RishWijewardhena/Hena-Jet/machanical part/camera bracket/v-slot-aluminium-extrusion-bar-20mm-x-20mm-1.snapshot.15/Dimensions - Cross Section.PNG

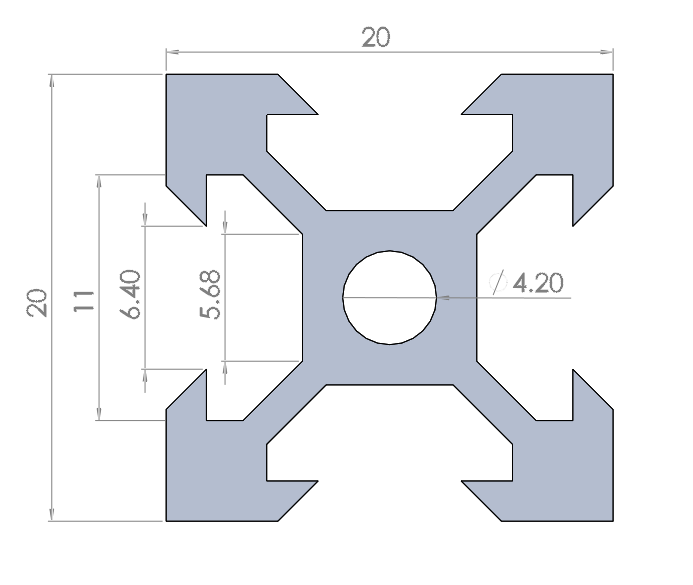
machanical part/camera bracket/v-slot-aluminium-extrusion-bar-20mm-x-20mm-1.snapshot.15/Dimensions - Cross Section.PNG
