RishWijewardhena/Hena-Jet/machanical part/camera bracket/Assembly 1.stl

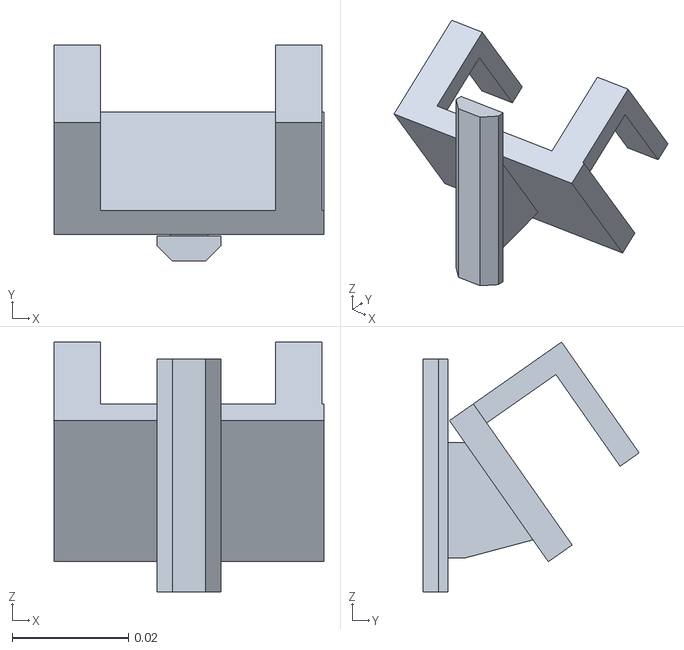
[picture p25: CAD file, 2026-07-02]
machanical part/camera bracket/Assembly 1.stl
0.0464 x 0.0371 x 0.0429
