RishWijewardhena/Hena-Jet/machanical part/camera bracket/flat camera bracket.step

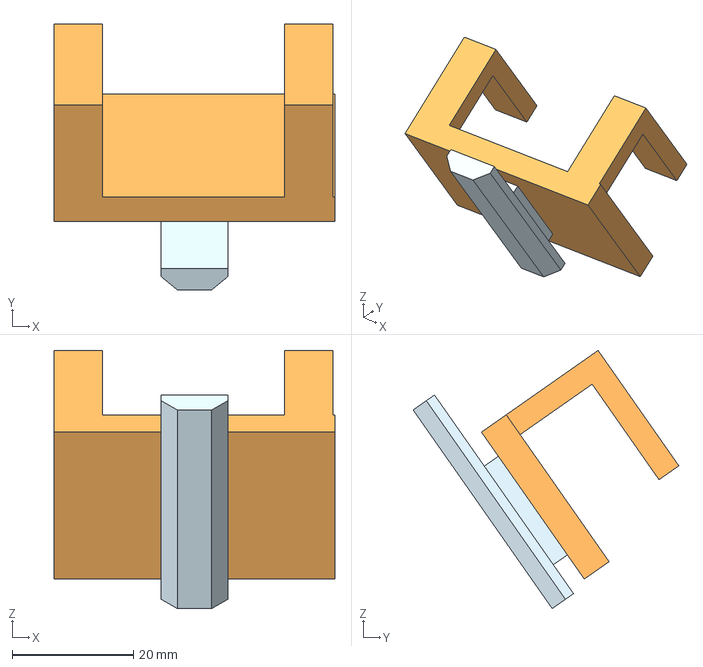
[picture p26: CAD file, 2026-07-16]
machanical part/camera bracket/flat camera bracket.step
46.4 x 43.8 x 42.6 mm
