RishWijewardhena/Hena-Jet/machanical part/camera bracket/v-slot-aluminium-extrusion-bar-20mm-x-20mm-1.snapshot.15/model (V-Slot 20x20mm).SLDPRT

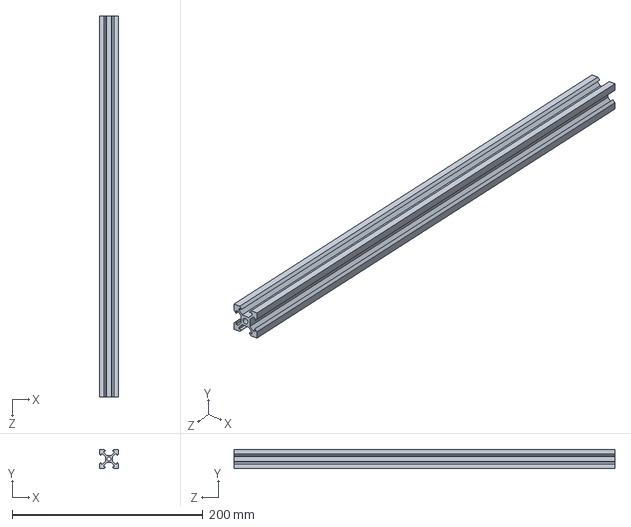
[picture p27: CAD file, 2026-07-02]
machanical part/camera bracket/v-slot-aluminium-extrusion-bar-20mm-x-20mm-1.snapshot.15/model (V-Slot 20x20mm).SLDPRT
20.0 x 20.0 x 400.0 mm
