RishWijewardhena/Hena-Jet/machanical part/camera bracket/camera_mount.step

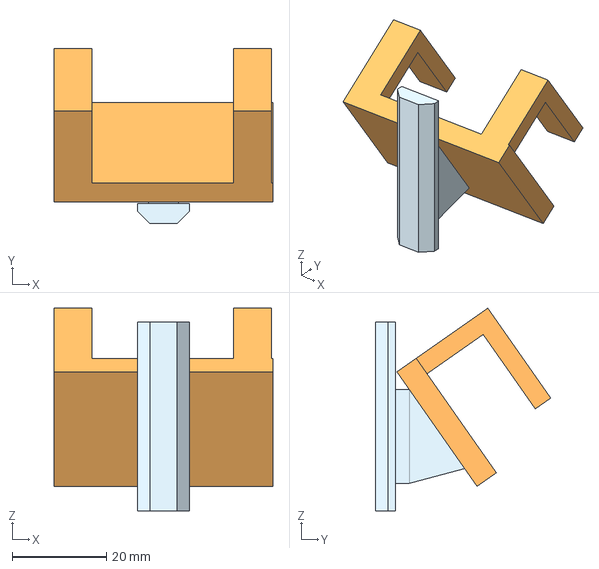
[picture p28: CAD file, 2026-07-02]
machanical part/camera bracket/camera_mount.step
46.4 x 37.1 x 42.9 mm
