RishWijewardhena/Hena-Jet/(list of files, cad)

Other CAD files:
machanical part/camera bracket/flat camera bracket.stl
