RishWijewardhena/Hena-Jet/scripts/sync_workflow/main_scan.py

#!/usr/bin/env python3
"""Main orchestrator for 360-degree motor-controlled scanning.

Captures aligned RGB-D frames at each motor angle, saves per-angle PLY files,
and optionally invokes reconstruct_pipeline.py for Open3D/Trimesh-based
registration and merging.
"""

import argparse
import json
import logging
import subprocess
import sys
import time

import numpy as np
from pathlib import Path

from motor_controller import MotorController
from camera_controller import CameraController
from pointcloud_export import backproject_to_points
from orbit_geometry import select_orbit_geometry, load_orbit_geometry, validate_camera_frame

logging.basicConfig(level=logging.INFO, format="%(asctime)s [%(levelname)s] %(message)s")
logger = logging.getLogger(__name__)


def parse_args(argv=None):
    parser = argparse.ArgumentParser(description="360 Motor-Controlled Scanner")
    parser.add_argument("--port", type=str, default="/dev/ttyACM0", help="Motor controller serial port")
    parser.add_argument("--baud", type=int, default=250000, help="Baud rate")
    parser.add_argument("--step-deg", type=float, default=10.0, help="Degrees to step per capture")
    parser.add_argument("--disparity", type=str, default="128", choices=["128", "256"], help="Disparity search range")
    parser.add_argument("--width", type=int, default=1280, help="Camera width resolution")
    parser.add_argument("--height", type=int, default=800, help="Camera height resolution")
    parser.add_argument("--fps", type=int, default=30, help="Camera framerate")
    parser.add_argument("--radius-m", type=float, default=None,
                        help="Radius from camera optical center to orbit center in metres "
                             "(defaults to the measured calibration radius)")
    parser.add_argument(
        "--x-positions-mm",
        type=float,
        nargs="+",
        default=[150.0],
        help="Absolute X stations to scan in millimetres (default: 150)",
    )
    parser.add_argument("--orbit-geometry", type=Path, default=None,
                        help="Measured calibration JSON (default: repository outputs/test_radius_x100/radius_calibration.json)")
    parser.add_argument("--orbit-axis", type=float, nargs=3, default=[1.0, 0.0, 0.0],
                        help="Legacy axis option; measured calibration supplies the reconstruction axis")
    parser.add_argument("--registration-mode", choices=("motor", "guarded-icp"),
                        default="guarded-icp",
                        help="Reconstruction pose source (default: guarded-icp). "
                             "Guarded ICP records per-edge fitness, residual and "
                             "loop closure, which motor mode does not produce at "
                             "all, and falls back to the motor prior whenever a "
                             "correction fails its guards. Pass motor to skip ICP")
    parser.add_argument(
        "--exclude-high-drift-frames",
        action="store_true",
        help=(
            "When auto-reconstructing with guarded ICP, omit sequential frames "
            "whose ICP correction exceeds the pose guards"
        ),
    )
    parser.add_argument("--frames-per-angle", type=int, default=6,
                        help="Fresh RGB-D frames to median-combine at each angle")
    parser.add_argument("--min-valid-samples", type=int, default=3,
                        help="Valid temporal samples a pixel needs to survive fusion")
    parser.add_argument("--depth-min-m", type=float, default=0.02,
                        help="Discard depth closer than this distance")
    parser.add_argument("--depth-max-m", type=float, default=0.25,
                        help="Discard depth farther than this distance")
    parser.add_argument("--crop-radius-m", type=float, default=0.085,
                        help="Final reconstruction crop limit around the orbit center")
    parser.add_argument(
        "--registration-crop-radius-m",
        type=float,
        default=None,
        help=(
            "Tighter crop-cube half-extent used only by guarded ICP "
            "(default: min(final crop, 0.10 m))"
        ),
    )
    parser.add_argument(
        "--crop-shape",
        choices=("cube", "cylinder"),
        default="cylinder",
        help=(
            "Reconstruction crop geometry: 'cylinder' reads the crop radii as "
            "radial limits around the orbit axis, which drops the enclosure "
            "ring without clipping the object along the axis (default: cube)"
        ),
    )
    parser.add_argument(
        "--crop-axial-half-length-m",
        type=float,
        default=0.30,
        help="Half-length along the orbit axis for --crop-shape cylinder",
    )
    parser.add_argument("--output-dir", type=Path, default=Path("outputs/scan"), help="Output directory for PLY files")
    parser.add_argument("--dry-run", action="store_true", help="Print sequence without moving or capturing")
    parser.add_argument("--no-home", action="store_true", help="Skip the homing sequence (use only if already homed)")
    parser.add_argument("--reconstruct", action="store_true", help="Auto-run reconstruct_pipeline.py after capture")

    args = parser.parse_args(argv)
    if args.registration_crop_radius_m is None:
        args.registration_crop_radius_m = 0.10
        if args.crop_radius_m > 0.0:
            args.registration_crop_radius_m = min(
                args.registration_crop_radius_m,
                args.crop_radius_m,
            )
    args.orbit_geometry = select_orbit_geometry(args.orbit_geometry)
    return args


def generate_angle_sequence(step_deg):
    """Generates the scan sequence: 0 to 180, then back to 0, then to -180."""
    sequence = []

    # 0 to 180
    pos_angles = np.arange(0.0, 180.0 + step_deg, step_deg)
    for ang in pos_angles:
        sequence.append({"angle": ang, "capture": True})

    # Return to 0 without capturing
    sequence.append({"angle": 0.0, "capture": False})

    # -step to -180
    neg_angles = np.arange(-step_deg, -180.0 - step_deg, -step_deg)
    for ang in neg_angles:
        sequence.append({"angle": ang, "capture": True})

    return sequence


def generate_scan_sequence(step_deg, x_positions_mm):
    """Build safe absolute-X moves and one complete orbit per X station."""
    sequence = []
    for station_index, x_position_mm in enumerate(x_positions_mm):
        sequence.append({
            "kind": "move_x",
            "capture": False,
            "station_index": station_index,
            "x_position_mm": float(x_position_mm),
        })
        for angle_step in generate_angle_sequence(step_deg):
            sequence.append({
                "kind": "move_y",
                "capture": angle_step["capture"],
                "station_index": station_index,
                "x_position_mm": float(x_position_mm),
                "angle_deg": float(angle_step["angle"]),
            })
        # Always put Y at zero before the next absolute X move.
        sequence.append({
            "kind": "move_y",
            "capture": False,
            "station_index": station_index,
            "x_position_mm": float(x_position_mm),
            "angle_deg": 0.0,
        })
    return sequence


def capture_filename(station_index, x_position_mm, angle_deg):
    """Return a unique, sortable filename for one station/angle capture."""
    return (
        f"frame_s{station_index:02d}_x{x_position_mm:.1f}_"
        f"y{angle_deg:+06.1f}.ply"
    )


def color_frame_to_rgb(color_frame):
    """Convert Orbbec color frame to numpy RGB array."""
    width = color_frame.get_width()
    height = color_frame.get_height()
    data = np.frombuffer(color_frame.get_data(), dtype=np.uint8).reshape((height, width, 3))
    return data


def depth_frame_to_meters(depth_frame):
    """Convert Orbbec depth frame to meters as float32."""
    width = depth_frame.get_width()
    height = depth_frame.get_height()
    depth_scale_mm = float(depth_frame.get_depth_scale())
    depth_raw = np.frombuffer(depth_frame.get_data(), dtype=np.uint16).reshape((height, width))
    depth_m = depth_raw.astype(np.float32) * (depth_scale_mm / 1000.0)
    return depth_m


def fuse_depth_frames(depth_frames, *, min_depth_m, max_depth_m, min_valid_samples=1):
    """Median-combine valid depth samples and mask points outside the work area."""
    if not depth_frames:
        raise ValueError("At least one depth frame is required.")
    if min_depth_m < 0.0 or max_depth_m <= min_depth_m:
        raise ValueError("Depth range must satisfy 0 <= min_depth_m < max_depth_m.")

    shapes = {np.asarray(frame).shape for frame in depth_frames}
    if len(shapes) != 1:
        raise ValueError("All depth frames must have the same shape.")

    stack = np.stack(depth_frames).astype(np.float32, copy=False)
    valid = (
        np.isfinite(stack)
        & (stack >= min_depth_m)
        & (stack <= max_depth_m)
    )
    masked = np.ma.array(stack, mask=~valid)
    fused = np.ma.median(masked, axis=0).filled(0.0).astype(np.float32)
    if min_valid_samples > 1:
        fused[valid.sum(axis=0) < min_valid_samples] = 0.0
    return fused


def capture_fused_rgbd(
    camera,
    *,
    frames_per_angle,
    timeout_ms,
    min_depth_m,
    max_depth_m,
    min_valid_samples=1,
):
    """Capture a fresh burst and return the latest color plus median depth."""
    if frames_per_angle < 1:
        raise ValueError("frames_per_angle must be at least 1.")

    depth_frames = []
    latest_color = None
    for _ in range(frames_per_angle):
        color_frame, depth_frame = camera.capture_aligned_rgbd(timeout_ms=timeout_ms)
        if color_frame is None or depth_frame is None:
            continue
        latest_color = color_frame_to_rgb(color_frame).copy()
        depth_frames.append(depth_frame_to_meters(depth_frame))

    if latest_color is None or not depth_frames:
        return None, None, 0

    fused_depth = fuse_depth_frames(
        depth_frames,
        min_depth_m=min_depth_m,
        max_depth_m=max_depth_m,
        min_valid_samples=min_valid_samples,
    )
    return latest_color, fused_depth, len(depth_frames)


def build_scan_metadata(args, *, active_disparity, captured_angles, captures=None):
    """Create the portable capture contract consumed by reconstruction."""
    return {
        "schema_version": 2,
        "orbit_radius_m": args.radius_m,
        "orbit_geometry_source": str(args.orbit_geometry),
        "orbit_axis": [float(value) for value in args.orbit_axis],
        "step_deg": float(args.step_deg),
        "registration_mode": args.registration_mode,
        "exclude_high_drift_frames": bool(args.exclude_high_drift_frames),
        "capture": {
            "width": int(args.width),
            "height": int(args.height),
            "fps": int(args.fps),
            "disparity": int(active_disparity),
            "frames_per_angle": int(args.frames_per_angle),
            "min_valid_samples": int(args.min_valid_samples),
            "depth_range_m": [float(args.depth_min_m), float(args.depth_max_m)],
        },
        "reconstruction": {
            "crop_radius_m": float(args.crop_radius_m),
            "registration_crop_radius_m": float(args.registration_crop_radius_m),
            "crop_shape": args.crop_shape,
            "crop_axial_half_length_m": float(args.crop_axial_half_length_m),
        },
        "x_stage": {
            "positions_mm": [float(value) for value in args.x_positions_mm],
            "reference_position_mm": float(args.x_positions_mm[0]),
            "positive_direction": "+orbit_axis",
        },
        "captured_angles_deg": [float(value) for value in captured_angles],
        "captures": list(captures or []),
    }


def save_frame_as_ply(
    color_rgb,
    depth_m,
    intrinsics,
    angle_deg,
    output_dir,
    *,
    depth_trunc_m=3.0,
    filename=None,
):
    """Create a colored point cloud from RGBD and save as PLY."""
    import open3d as o3d

    points, colors = backproject_to_points(
        depth_m, color_rgb, intrinsics, depth_trunc_m=depth_trunc_m
    )
    pcd = o3d.geometry.PointCloud()
    pcd.points = o3d.utility.Vector3dVector(points)
    pcd.colors = o3d.utility.Vector3dVector(colors)

    out_path = output_dir / (filename or f"frame_{angle_deg:.1f}.ply")
    o3d.io.write_point_cloud(str(out_path), pcd)
    logger.info("Saved %d points -> %s", len(pcd.points), out_path.name)
    return out_path


def prepare_scan_geometry(args):
    """Validate the rig calibration before hardware access and resolve metadata."""
    calibration = load_orbit_geometry(args.orbit_geometry)
    if args.radius_m is None:
        args.radius_m = float(calibration["recommended_radius_m"])
    if not np.isfinite(args.radius_m) or args.radius_m <= 0:
        raise ValueError("--radius-m must be finite and positive")
    args.orbit_axis = calibration["orbit_geometry"]["axis"]
    return calibration


def build_reconstruction_command(args):
    """Forward the same measured geometry used to describe the scan."""
    cmd = [
        sys.executable,
        str(Path(__file__).parent / "reconstruct_pipeline.py"),
        "--input-dir", str(args.output_dir),
        "--orbit-radius-m", str(args.radius_m),
        "--registration-mode", args.registration_mode,
        "--orbit-geometry", str(args.orbit_geometry),
        "--crop-radius-m", str(args.crop_radius_m),
        "--registration-crop-radius-m", str(args.registration_crop_radius_m),
        "--crop-shape", args.crop_shape,
        "--crop-axial-half-length-m", str(args.crop_axial_half_length_m),
    ]
    if args.exclude_high_drift_frames:
        cmd.append("--exclude-high-drift-frames")

    return cmd


def main():
    args = parse_args()

    if args.frames_per_angle < 1:
        raise ValueError("--frames-per-angle must be at least 1.")
    if args.min_valid_samples < 1 or args.min_valid_samples > args.frames_per_angle:
        raise ValueError("--min-valid-samples must be within [1, --frames-per-angle].")
    if args.depth_min_m < 0.0 or args.depth_max_m <= args.depth_min_m:
        raise ValueError("Depth range must satisfy 0 <= min < max.")
    if args.radius_m is not None and args.radius_m <= 0.0:
        raise ValueError("--radius-m must be positive.")
    if not np.isfinite(args.crop_radius_m) or args.crop_radius_m <= 0.0:
        raise ValueError("--crop-radius-m must be finite and positive.")
    if (
        not np.isfinite(args.registration_crop_radius_m)
        or args.registration_crop_radius_m <= 0.0
    ):
        raise ValueError("--registration-crop-radius-m must be finite and positive.")
    if (
        not np.isfinite(args.crop_axial_half_length_m)
        or args.crop_axial_half_length_m <= 0.0
    ):
        raise ValueError("--crop-axial-half-length-m must be finite and positive.")
    if not args.x_positions_mm or not all(np.isfinite(args.x_positions_mm)):
        raise ValueError("--x-positions-mm must contain finite positions.")
    if len(set(args.x_positions_mm)) != len(args.x_positions_mm):
        raise ValueError("--x-positions-mm must not contain duplicates.")
    if len({f"{value:.1f}" for value in args.x_positions_mm}) != len(args.x_positions_mm):
        raise ValueError("--x-positions-mm must be unique at 0.1 mm precision.")
    calibration = prepare_scan_geometry(args)
    if args.exclude_high_drift_frames and args.registration_mode != "guarded-icp":
        raise ValueError("--exclude-high-drift-frames requires guarded-icp")

    # Ensure output dir exists
    args.output_dir.mkdir(parents=True, exist_ok=True)

    scan_sequence = generate_scan_sequence(args.step_deg, args.x_positions_mm)

    if args.dry_run:
        logger.info("[DRY RUN] Would home motors here.")
        logger.info("[DRY RUN] Would select absolute positioning with G90.")
        for step in scan_sequence:
            if step["kind"] == "move_x":
                logger.info(
                    "[DRY RUN] Would move X to %.1f mm at Y=0.",
                    step["x_position_mm"],
                )
                continue
            angle = step["angle_deg"]
            logger.info("[DRY RUN] Would move Y to %.1f degrees.", angle)
            if step["capture"]:
                logger.info(
                    "[DRY RUN] Would capture station %d at X=%.1f, Y=%.1f.",
                    step["station_index"], step["x_position_mm"], angle,
                )
        logger.info("[DRY RUN] Sequence complete.")
        return

    logger.info("Initializing hardware...")

    saved_files = []
    captured_angles = []
    capture_manifest = []
    metadata_path = args.output_dir / "scan_metadata.json"

    with MotorController(port=args.port, baud=args.baud) as motor, \
         CameraController(width=args.width, height=args.height, fps=args.fps, disparity=args.disparity) as camera:

        validate_camera_frame(calibration, camera.intrinsics)

        if not args.no_home:
            motor.home_all()
        if not motor.send_command("G90"):
            raise RuntimeError("Failed to select absolute motor positioning.")

        # Save intrinsics once
        if camera.intrinsics:
            intrinsics_path = args.output_dir / "intrinsics.json"
            intrinsics_path.write_text(
                json.dumps(camera.intrinsics, indent=2), encoding="utf-8",
            )
            logger.info("Saved intrinsics to %s", intrinsics_path)

        metadata_path.write_text(
            json.dumps(
                build_scan_metadata(
                    args,
                    active_disparity=camera.active_disparity,
                    captured_angles=captured_angles,
                    captures=capture_manifest,
                ),
                indent=2,
            ) + "\n",
            encoding="utf-8",
        )
        logger.info("Saved scan settings to %s", metadata_path)

        logger.info("Starting scan with %d motion steps.", len(scan_sequence))

        for step in scan_sequence:
            if step["kind"] == "move_x":
                logger.info(
                    "Moving to station %d at X=%.1f mm...",
                    step["station_index"], step["x_position_mm"],
                )
                motor.move_x(step["x_position_mm"], feedrate=500)
                time.sleep(0.5)
                continue

            angle = step["angle_deg"]
            should_capture = step["capture"]

            logger.info("Moving Y to %.1f degrees...", angle)
            motor.move_y(angle, feedrate=800)

            # Brief pause to let camera settle after movement
            time.sleep(0.1)

            if should_capture:
                logger.info("Capturing frame at %.1f degrees...", angle)
                color_rgb, depth_m, captured_count = capture_fused_rgbd(
                    camera,
                    frames_per_angle=args.frames_per_angle,
                    timeout_ms=2000,
                    min_depth_m=args.depth_min_m,
                    max_depth_m=args.depth_max_m,
                    min_valid_samples=args.min_valid_samples,
                )

                if color_rgb is not None and depth_m is not None:
                    valid_percent = 100.0 * np.count_nonzero(depth_m) / depth_m.size
                    logger.info(
                        "Combined %d/%d frames; %.1f%% valid depth in %.3f-%.3f m",
                        captured_count,
                        args.frames_per_angle,
                        valid_percent,
                        args.depth_min_m,
                        args.depth_max_m,
                    )
                    ply_path = save_frame_as_ply(
                        color_rgb,
                        depth_m,
                        camera.intrinsics,
                        angle,
                        args.output_dir,
                        depth_trunc_m=args.depth_max_m,
                        filename=capture_filename(
                            step["station_index"],
                            step["x_position_mm"],
                            angle,
                        ),
                    )
                    saved_files.append(ply_path)
                    captured_angles.append(float(angle))
                    capture_manifest.append({
                        "filename": ply_path.name,
                        "station_index": int(step["station_index"]),
                        "x_position_mm": float(step["x_position_mm"]),
                        "x_offset_m": float(
                            (step["x_position_mm"] - args.x_positions_mm[0]) / 1000.0
                        ),
                        "angle_deg": float(angle),
                    })
                    metadata_path.write_text(
                        json.dumps(
                            build_scan_metadata(
                                args,
                                active_disparity=camera.active_disparity,
                                captured_angles=captured_angles,
                                captures=capture_manifest,
                            ),
                            indent=2,
                        ) + "\n",
                        encoding="utf-8",
                    )
                else:
                    logger.error(
                        "Failed to capture any complete frame at %.1f degrees. Skipping.",
                        angle,
                    )
            else:
                logger.info("Returning to %.1f degrees (no capture).", angle)

    logger.info("Capture complete. Saved %d point clouds to %s", len(saved_files), args.output_dir)

    # Optionally invoke reconstruction
    if args.reconstruct and len(saved_files) > 0:
        logger.info("Launching reconstruction pipeline...")
        cmd = build_reconstruction_command(args)

        logger.info("$ %s", " ".join(cmd))
        subprocess.run(cmd, check=True)
    elif len(saved_files) > 0:
        logger.info(
            "To reconstruct, run:\n"
            "  python %s/reconstruct_pipeline.py --input-dir %s",
            Path(__file__).parent,
            args.output_dir,
        )
    else:
        logger.warning("No frames were captured.")


if __name__ == "__main__":
    main()
