RishWijewardhena/Hena-Jet/(commit log)

2026-06-22 chore: initialize scanner project workspace
    - Add the project README and initial scanner feasibility notes for the ZED-M workflow.
    - Add baseline ZED angle capture, circular point-cloud merge, and TSDF fusion scripts.
    - Add calibration sweep helpers and ignore rules for generated scanner outputs.
2026-06-23 feat: add camera capture and KISS-ICP mapping tools
    - Add interactive OAK-D RGB-D capture and point-cloud export for manual scanner angles.
    - Add interactive ZED RGB-D capture with IMAGE coordinate support and point-cloud export.
    - Add realtime ZED KISS-ICP mapping with live Open3D visualization and trajectory export.
    - Update circular point-cloud merging for IMAGE captures, rig pivot correction, and optional ICP refinement.
    - Add offline KISS-ICP local-map export from captured point-cloud datasets.
2026-06-24 feat: add live ZED TSDF posegraph mapper
    - Capture ZED left RGB-D frames for Open3D odometry without relying on IMU or KISS-ICP.
    - Build live TSDF previews for single-circle and guided scanning modes.
    - Optimize the pose graph after capture and rebuild final mesh, cloud, pose, and scan metadata outputs.
2026-07-02 feat: add multi-camera reconstruction workflows
    - Add ZED Mini capture, Open3D dataset export, offline reconstruction, and TSDF rebuild scripts.
    - Add ZED-M ArUco table-board alignment tools for printable marker generation, pose debugging, and marker-based TSDF fusion.
    - Add OAK-D live and offline circular TSDF fusion scripts for manual-angle RGB-D scanning.
    - Update the live ZED posegraph mapper and local ignore rules for scanner runtime artifacts.
2026-07-02 docs: add scanner reference notes
    - Add the Johnson and Lorenzo report notes used to reason about fixed-object, moving-camera scanning.
    - Add the original Johnson and Lorenzo report PDF for future reference.
    - Add Open3D reconstruction notes explaining the RGB-D, posegraph, and TSDF concepts used by the scanner scripts.
2026-07-02 chore: keep ZED-M branch focused
    - Remove OAK-D capture and TSDF fusion scripts from the ZED-M branch.
    - Keep ZED, ZED-M, ArUco alignment, reconstruction utilities, and shared scanner docs on this branch.
    - Preserve OAK-D work in its own camera-specific branch for future development.
2026-07-02 chore: add ZED-M camera bracket design
    - Add the ZED-M camera mount STEP and assembled STL design files.
    - Add the 20x20 V-slot extrusion reference model, previews, and snapshot archive used by the bracket design.
    - Keep the mechanical bracket assets with the ZED-M branch because the design is camera-specific.
    [Assembly 1.stl, camera_mount.step, model (V-Slot 20x20mm).SLDPRT]
2026-07-03 feat: add auto-capture mode to ZED ArUco TSDF scanner
    - Add an auto-capture mode so the scanner can collect frames without pressing Enter for every capture.
    - Add a configurable capture interval for automatic scan attempts.
    - Add a max-frame limit so automatic scans can stop after a fixed number of accepted frames.
    - Validate the new auto-capture arguments before opening the ZED camera.
2026-07-03 docs: add mechanical pose limitations note
    - Document why angle and radius alone are not enough for accurate point-cloud alignment.
    - List the mechanical calibration inputs needed for circular camera-pose estimation.
    - Compare mechanical-only pose with ArUco pose for ZED-M hand scanning.
2026-07-03 docs: explain Open3D TSDF integration
    - Add a ZED ArUco scanner note explaining TSDF activation, integration, and extraction.
    - Map Open3D integration inputs to RGB-D frames, intrinsics, and ArUco world-to-camera poses.
    - Document why TSDF smoothing still needs depth cleanup and scene filtering.
2026-07-03 docs: add ZED ArUco scan tuning guidance
    - Document auto-capture usage and accepted-frame behavior.
    - Add mesh and point-cloud tuning guidance for depth range, ROI, TSDF voxel size, and truncation.
    - Explain current noise limits around marker masking, table geometry, and missing cleanup steps.
2026-07-03 feat: lower default ZED ArUco max depth
    - Change the default max depth from 0.21 m to 0.18 m for closer hand scans.
    - Reduce the chance that table and background depth are fused into the TSDF volume by default.
    - Keep the value configurable through the existing --max-depth-m argument.
2026-07-06 fix: handle ZED ArUco scan interrupt cleanly
    - Add a SIGINT handler so Ctrl+C requests a graceful stop instead of interrupting camera work immediately.
    - Let the active ZED grab/retrieve step finish before leaving the capture loop and saving outputs.
    - Restore the previous SIGINT handler after camera cleanup and document the auto-capture stop behavior.
2026-07-07 feat: clean ZED ArUco scan outputs
    - Add conservative mesh hole filling using Open3D tensor mesh conversion before saving TSDF meshes.
    - Add statistical outlier removal for final point clouds and small connected-component removal for mesh fragments.
    - Expose cleanup and hole-fill controls through CLI flags and document the tuning defaults in the ArUco README.
2026-07-13 feat: improve close-range ZED KISS-ICP scans
    - Add confidence, range, boundary, and depth-edge filtering with deterministic close-range ICP sampling.
    - Reject sparse, degenerate, and excessive-motion frames while recording per-frame quality diagnostics.
    - Fuse accepted frames into an observation-weighted global voxel map and document the reliable scan workflow.
2026-07-16 chore(camera-bracket): reorganize mechanical design assets
    - Move existing camera mount and extrusion models into the mechanical workspace. [camera bracket/, machanical part/camera bracket/]
    - Add flat camera-bracket STEP and STL variants. [machanical part/camera bracket/flat camera bracket.step, machanical part/camera bracket/flat camera bracket.stl]
    [Assembly 1.stl, camera_mount.step, flat camera bracket.step, flat camera bracket.stl, model (V-Slot 20x20mm).SLDPRT]
2026-07-16 feat(encoder): add serial counting utilities
    - Add ESP32 quadrature counting and serial reporting. [machanical part/Encoder_count/Encoder_raw_count/Encoder_raw_count.ino]
    - Add a desktop angle display with tare control. [machanical part/Encoder_count/Count_UI.py]
    - Add encoder-driven ZED capture support. [scripts/capture_zed_auto_with_encoder.py]
2026-07-16 feat(motor-controller): add HBT4248C control stack
    - Add ESP32 serial commands, alarm monitoring, and step-pulse control. [machanical part/Motor controlling/src/main.cpp]
    - Add reusable S-curve motion calculations and native coverage. [machanical part/Motor controlling/src/motion_math.h, machanical part/Motor controlling/tests/test_motion_math.cpp]
    - Add the Tkinter controller, serial protocol parsing, and protocol tests. [machanical part/Motor controlling/motor_controller_gui.py, machanical part/Motor controlling/serial_protocol.py, machanical part/Motor controlling/tests/test_serial_protocol.py]
    - Add project configuration, dependencies, documentation, and ignore rules. [machanical part/Mo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
2026-07-16 feat(capture-zed-angle): synchronize capture with motor steps
    - Drive the serial motor sequence, capture each acknowledged segment, and stop on controller errors. [scripts/capture_zed_angle.py]
    - Cover serial start, acknowledgement, error, and stop behavior. [scripts/test/test_capture_zed_angle_serial.py]
2026-07-16 feat(feature-extraction): add tracked ZED reconstruction pipeline
    - Add RGB-D dataset capture and feature tracking with RANSAC and LightGlue. [scripts/feature_extraction/capture_zed_open3d_dataset.py, scripts/feature_extraction/rgbd_feature_ransac_tracker.py, scripts/feature_extraction/superpoint_lightglue_tracker.py]
    - Refine frame poses with ICP and global pose-graph optimization. [scripts/feature_extraction/refine_feature_poses_icp.py, scripts/feature_extraction/optimize_feature_pose_graph.py]
    - Fuse tracked RGB-D frames into TSDF output and share fusion controls. [scripts/feature_extraction/fuse_feature_tracked_rgbd.py, scripts/fuse_tsdf_scan.py]
    - Add pipeline orchestration and workflow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
2026-08-13 feat(transform-clouds): add camera-independent reconstruction
    - Register angle-indexed point clouds from calibrated orbit geometry without importing the ZED SDK. [scripts/transform_clouds.py, scripts/transform_clouds_pipeline.py]
    - Cover orbit poses, guarded ICP, pose-graph quality gates, and runtime configuration. [scripts/test/test_transform_clouds.py]
    - Document the markerless reconstruction workflow and architectural decision. [docs/transform_clouds.md, docs/transform_clouds_pipeline.md, docs/decisions/001-markerless-plane-pose-graph-registration.md]
2026-08-13 feat(rgbd-fusion): add offline orbit pose graph
    - Fuse saved RGB-D frames from calibrated orbit or recorded pose sources without a camera SDK dependency. [scripts/fuse_orbit_posegraph.py, scripts/fuse_tsdf_scan.py]
    - Test pose direction, confidence filtering, cropping, cleanup, and orbit diagnostics. [scripts/test/test_fuse_orbit_posegraph.py]
    - Document feasibility controls and quality evidence for offline fusion. [docs/orbit_posegraph_fusion_spec.md]
2026-08-13 refactor(kiss-icp): group offline utilities
    - Move quality filtering and offline map export into the KISS-ICP subfolder. [scripts/kiss_ICP/]
    - Keep the pyzed-based realtime scanner outside this migration. [scripts/kiss_icp_realtime.py]
    - Update quality tests to use the reorganized camera-independent module path. [scripts/test/test_kiss_icp_quality.py]
2026-08-13 feat(mano): add camera-independent hand model checks
    - Generate neutral MANO meshes without relying on a camera SDK. [scripts/mano_smoke_test.py]
    - Verify left and right meshes against locally licensed model files. [scripts/test/test_mano_smoke_test.py]
    - Document the hand reconstruction architecture, MANO setup, and local model exclusion. [docs/hena_jet_mano_hand_reconstruction_plan.md, docs/mano_README.md, .gitignore]
2026-08-13 feat(lingbot-depth): add offline depth completion
    - Complete missing depth in saved RGB-D captures without importing the ZED SDK. [scripts/batch_lingbot_depth.py]
    - Test discovery, filtering, intrinsics, artifact completeness, and point-cloud export. [scripts/test/test_batch_lingbot_depth.py]
    - Pin the public LingBot model implementation that provides the mdm package. [.gitmodules, lingbot-depth]
2026-08-13 test(mesh-reconstruction): refine alpha-shape example
    - Increase surface sampling and use a finer alpha radius for the camera-independent Bunny mesh experiment. [scripts/test/test1.py]
2026-08-13 chore(gemini-305): remove legacy ZED auto capture
    - Remove the encoder-driven ZED SDK capture utility from the Orbbec-focused branch. [scripts/capture_zed_auto_with_encoder.py]
2026-08-14 feat: stream Gemini 305 frames into KISS-ICP
    Replace the offline GenericDataset input with the Orbbec SDK depth pipeline. Normalize Gemini XYZ millimetres to metres, use the 848x530 close-range profile, and save the map and poses when capture stops.
2026-08-14 fix: apply Gemini depth scale to ICP points
    Gemini 305 reports XYZ in native 0.1 mm units. Configure PointCloudFilter with each stream's reported depth scale before converting normalized millimetres to metres, preventing ten-times range inflation and false ICP motion.
2026-08-14 feat(kiss-icp): export aligned colored voxel map
    - Synchronize matching Gemini 305 RGB-D streams and decode aligned XYZRGB records for live registration. [scripts/kiss_ICP/run_kiss_icp_export_map.py]
    - Fuse accepted colored frames into a pose-transformed, sample-weighted voxel map and export RGB PLY data. [scripts/kiss_ICP/run_kiss_icp_export_map.py]
    - Test Gemini unit normalization, RGB correspondence, PLY colors, pose transforms, and weighted voxel averages. [tests/test_kiss_icp_gemini_live.py]
2026-08-14 feat(kiss-icp): filter Gemini depth before D2C
    - Apply SDK edge-noise removal and device-recommended hole filling before alignment and point-cloud generation, without decimation. [scripts/kiss_ICP/run_kiss_icp_export_map.py]
    - Preserve synchronized RGB for D2C alignment and test filter selection, ordering, and RGB-D frame-set rebuilding. [tests/test_kiss_icp_gemini_live.py]
2026-08-14 feat(gemini-capture): add TUM RGB-D recorder
    - Record SDK-filtered, D2C-aligned Gemini 305 RGB-D frames with matching KISS-ICP poses for offline SurfelMeshing. [scripts/gemini305_tum_capture/capture_tum_rgbd.py]
    - Test depth and color serialization, TUM metadata, pose conversion, and overwrite protection without camera hardware. [scripts/gemini305_tum_capture/test_capture_tum_rgbd.py]
    - Document laptop capture commands, output layout, and the Jetson Orin Nano deployment boundary. [scripts/gemini305_tum_capture/README.md]
2026-08-17 feat(orbbec-aruco): migrate table-board alignment to Orbbec SDK
    - Extract factory RGB intrinsics and distortion coefficients from OBCameraParam and decode multi-format color and Y16 depth frames. [scripts/orbbec_aruco_alignment/aruco_common.py]
    - Capture Orbbec RGB stream, detect ArUco markers, solve 6-DoF table pose, and export debug overlays without TSDF fusion. [scripts/orbbec_aruco_alignment/orbbec_aruco_pose_debug.py]
    - Stream synchronized Orbbec Color and Depth with Depth-to-Color alignment, estimate ArUco poses, and fuse RGB-D into an Open3D TSDF volume. [scripts/orbbec_aruco_alignment/orbbec_aruco_tsdf_scan.py]
    - Test color conversion, depth cleaning, marker masking, board detection,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
2026-08-18 feat(orbbec-aruco): integrate LingBot-Depth refinement and debug visualization
    - Add LingBot model loader and per-frame depth inference prior to TSDF volume integration. [scripts/orbbec_aruco_alignment/orbbec_aruco_tsdf_scan.py]
    - Add colorize_depth helper and --lingbot-debug CLI flag to export side-by-side comparisons and 16-bit millimeter depth maps to debug directory. [scripts/orbbec_aruco_alignment/orbbec_aruco_tsdf_scan.py]
    - Record LingBot model and device configurations in scan JSON metadata. [scripts/orbbec_aruco_alignment/orbbec_aruco_tsdf_scan.py]
2026-08-19 feat(sync_workflow): add motor and camera controller modules
    - Switch to SW_MODE for high-res D2C alignment. [scripts/sync_workflow/camera_controller.py]
    - Adjust G-code clearing movements to avoid limit switches. [scripts/sync_workflow/motor_controller.py]
    [camera_controller.py, motor_controller.py]
2026-08-19 feat(sync_workflow): decouple capture from TSDF processing
    - Save raw PLY point clouds directly to disk during scanning without inline TSDF integration. [scripts/sync_workflow/main_scan.py]
    - Save camera intrinsics as JSON for offline processing. [scripts/sync_workflow/main_scan.py]
2026-08-19 docs(sync_workflow): document the new two-phase architecture
    - Explain the separation of the capture script and the offline CloudCompare reconstruction pipeline. [scripts/sync_workflow/README.md]
    - Provide usage instructions and updated motor homing sequences. [scripts/sync_workflow/README.md]
2026-08-19 feat(sync-workflow): optimize pipeline and add auto-radius cropping
    - Replace batched CloudCompare calls with parallel ThreadPoolExecutor processing to fix saving errors and improve speed. [scripts/sync_workflow/reconstruct_pipeline.py]
    - Swap spatial subsampling and SOR filter order in the merge stage to prevent CPU and RAM exhaustion on uncropped clouds. [scripts/sync_workflow/reconstruct_pipeline.py]
    - Add `--auto-radius` feature to automatically calculate the physical orbit radius dynamically from the point cloud's depth. [scripts/sync_workflow/reconstruct_pipeline.py]
    - Implement `--crop-radius-m` to slice away background walls and noise before ICP registration and final merge. [scripts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
    [reconstruct_pipeline.py]
2026-08-19 fix(sync-workflow): flush stale camera frames before capture
    - Add a buffer flush loop in `capture_aligned_rgbd` to ensure the captured frame corresponds to the actual current motor position, rather than pulling delayed frames from the SDK queue. [scripts/sync_workflow/camera_controller.py]
    [camera_controller.py]
2026-08-20 feat(sync-workflow): update default radius to 145.87mm
    - Set the default orbit radius from camera to object center to the newly measured physical distance of 145.87mm (0.14587m). [scripts/sync_workflow/main_scan.py]
    - Sync the default fallback radius parameter in the reconstruction pipeline to match. [scripts/sync_workflow/reconstruct_pipeline.py]
2026-08-20 feat(sync-workflow): make X-axis the default orbit axis
    - Change the default `--orbit-axis` from Y to X (1 0 0) in the reconstruction pipeline to properly orient the horizontal forearm scans. [scripts/sync_workflow/reconstruct_pipeline.py]
2026-08-20 refactor(sync-workflow): remove poisson surface reconstruction
    - Remove the Poisson meshing stage from the reconstruction pipeline, focusing solely on producing the aligned and merged point cloud. [scripts/sync_workflow/reconstruct_pipeline.py]
    - Remove the `--no-mesh` flag from both scripts since meshing is no longer part of the pipeline. [scripts/sync_workflow/main_scan.py]
    [main_scan.py, reconstruct_pipeline.py]
2026-08-20 test(sync-workflow): add test script for radius capture
    - Add `test_radius.py` to capture test frames at X=400.
    - Capture at Y=-55 and Y=125 (opposite sides of the rig) to verify perspective changes and correct alignment. [scripts/sync_workflow/test_radius.py]
    [test_radius.py]
2026-08-20 fix(sync-workflow): verify camera disparity search range
    - Configure Gemini disparity through the correct SDK range-mode property and map 128/256 pixels to modes 1/2.
    - Read back the active mode and fail clearly when the camera does not apply the requested setting.
    - Add regression coverage for both ranges, matching-mode no-ops, and readback mismatches. [scripts/sync_workflow/camera_controller.py] [tests/test_sync_workflow_camera_controller.py]
    [camera_controller.py]
2026-08-20 fix(sync-workflow): constrain registration to motor priors
    - Add deterministic motor-only reconstruction and strict 5 mm / 2 degree guarded-ICP fallback.
    - Filter registration clouds before ICP and record effective settings, prior scores, and pose corrections.
    - Add regression coverage for motor defaults, ICP guards, pre-ICP SOR, metadata radius, and diagnostics.
    [reconstruct_pipeline.py]
2026-08-20 feat(sync-workflow): fuse close-range depth captures
    - Median-combine fresh RGB-D bursts and reject out-of-range samples before point-cloud export.
    - Persist scan radius, axis, depth settings, and captured angles in scan_metadata.json.
    - Expand test_radius.py into safe multi-angle rigid-target calibration capture and document the motor-first workflow.
2026-08-21 docs(sync-workflow): explain capture and reconstruction flow
    - Document camera capture, depth fusion, motor sequencing, metadata, and automatic reconstruction.
    - Explain orbit-radius geometry, motor and guarded-ICP modes, thresholds, cleanup, and outputs.
    - Add CLI references, calibration guidance, diagnostics interpretation, and troubleshooting.
2026-08-21 feat(sync-workflow): add Python point-cloud processing backend
    - Transform, crop, and filter colored scans with Open3D.
    - Merge, subsample, deduplicate, estimate normals, and validate final clouds with Open3D and Trimesh.
    - Cover the backend contract with real-library point-cloud tests.
2026-08-21 refactor(sync-workflow): replace CloudCompare processing
    - Route full-resolution transforms, cleanup, merging, and normal estimation through Open3D and Trimesh.
    - Preserve transformed clouds, pose matrices, merged output, and diagnostics while replacing the backend log.
    - Add an end-to-end motor reconstruction test that proves the pipeline runs without CloudCompare.
    [reconstruct_pipeline.py]
2026-08-21 docs(sync-workflow): document Python reconstruction backend
    - Replace CloudCompare stage descriptions with Open3D and Trimesh behavior.
    - Document processing.log, duplicate grouping, normal orientation, and final artifact validation.
    - Clarify that reconstruction no longer requires Flatpak or CloudCompare.
    [main_scan.py]
2026-08-21 fix(sync-workflow): enforce spatial sample distance
    - Refill Trimesh radius samples to a maximal set without violating the configured minimum spacing.
    - Preserve more surface detail than one-pass close-point removal while preventing cross-voxel near duplicates.
    - Add a regression test for the one-millimetre separation guarantee.
    [pointcloud_processing.py]
2026-08-25 feat(sync-workflow): add orbit radius calibration geometry
2026-08-25 feat(sync-workflow): generate printable radius markers
2026-08-25 docs(sync-workflow): document marker radius calibration
2026-08-25 fix(sync-workflow): reject degenerate radius trajectories
    [radius_calibration.py]
2026-08-26 feat(sync-workflow): finalize continuous wrap calibration
2026-09-02 feat(sync-workflow): improve orbit radius estimation accuracy
    - Move radius calibration, marker generation, and orbit pose mapping into a calculating_radius package.
    - Enable sub-pixel ArUco corner refinement and require multi-marker poses for the radius fit.
    - Fit the orbit circle to every accepted frame pose instead of one median per angle.
    - Refine the algebraic circle fit geometrically and report a bootstrap confidence interval for the radius.
    - Sample the calibration orbit every 30 degrees instead of 45.
2026-09-02 fix(sync-workflow): optimize quality metrics harness and fix test fixture
    - Load each transformed PLY exactly once into angle-keyed dict.
    - Add --subsample parameter (default 4) to reduce full-resolution point clouds.
    - Build cKDTree once per cloud and reuse across angle pairs (148 → 37 builds).
    - Raise default --patch-half-extent-m from 0.010 to 0.020 for better frame statistics.
    - Replace test fixture with regular grid (20mm spacing) to ensure places=4 tolerance passes.
    - Full baseline run now completes in ~1m47s (was >10min for 180° separation).
    - All 37 frames now contribute to single-frame metric (was 5 with 0.010 patch).
    [scan_quality_report.py]
2026-09-02 fix(sync-workflow): wire cKDTree reuse to actually reduce tree construction
    - Add optional tree_b parameter to cross_view_residual_m signature.
    - When tree_b is provided, use prebuilt tree; when None, build internally.
    - Pass cached trees from scan_quality_report to cross_view_residual_m calls.
    - Add unit test verifying prebuilt-tree path gives identical results to internal-build.
    - Fixes dead code scaffolding: all 37 built trees now consumed in cross-view loops.
    - Baseline metrics unchanged; timing: 1m44s (was 1m47s with unused trees).
    [depth_quality.py, scan_quality_report.py]
2026-09-02 feat(sync-workflow): back-project depth in float to remove 1mm quantisation
    - Back-project aligned RGB-D frames to coloured point clouds with exact float precision.
    - Replace Open3D's uint16 millimetre path that truncates and introduces -0.5 mm systematic bias.
    - Add comprehensive tests verifying sub-millimetre depth preservation and proper filtering.
    [main_scan.py, pointcloud_export.py]
2026-09-02 feat(sync-workflow): back-project aligned depth with RGB intrinsics
    - Return RGB intrinsics for software depth-to-color aligned frames, since D2C reprojects depth into the RGB image and coordinate system.
    - Keep depth-camera intrinsics for unaligned frames and label each set with its coordinate frame.
    - Configure the disparity search range explicitly when the device supports it.
2026-09-02 feat(sync-workflow): reconstruct from measured ArUco pose maps
    - Load an orbit pose map and build measured camera-to-reference priors instead of motor-angle priors.
    - Add a tighter registration crop radius used only by guarded ICP, defaulting to the smaller of 10 cm and the final crop.
    - Resolve the orbit radius from scan metadata when --auto-radius is requested.
    - Cover the pose-map contract and the crop-radius resolution with tests.
    [main_scan.py, reconstruct_pipeline.py]
2026-09-02 fix(sync-workflow): tune the homing sequence for the y limit switch
    - Move X to 25 mm to reach the Y limit switch during homing.
    - Park the mechanism at X30 Y0 after homing instead of X200 Y40.
    [motor_controller.py]
2026-09-02 feat(sync-workflow): convert merged point clouds to STL
    - Add a standalone converter from a merged PLY point cloud to an STL mesh.
2026-09-02 docs(sync-workflow): document pose-map reconstruction and crop radii
    - Explain the measured pose-map reconstruction path alongside the motor-angle path.
    - Describe the separate registration and final crop radii.
2026-09-02 feat(sync-workflow): apply the Orbbec recommended depth filter chain
    - Add depth_filters.py to select and apply the device's recommended depth post-processing chain (DisparityTransform, SpatialAdvanced, Temporal, NoiseRemoval, EdgeNoiseRemoval by default).
    - Wire CameraController to build the chain from the depth sensor's recommended filters after pipeline start, and apply it to every captured depth frame before it is returned.
    - Cover selection and chaining behaviour, including disabled and None-returning filters, with unit tests against a fake filter.
    [camera_controller.py, depth_filters.py]
2026-09-02 fix(sync-workflow): filter depth before D2C alignment, not after
    - Run the recommended depth filter chain on the raw, unaligned depth frame, then assemble a fresh frame set from the filtered depth plus the original colour frame before running AlignFilter, since the filters assume the native sensor neighbourhood and disparity domain rather than depth already resampled onto the colour grid.
    - Fall back to the previous align-then-filter order when frame-set reassembly is unavailable, logging a clear warning so the active path is visible at the rig, so capture never breaks over an unsupported reassembly path.
    - Remove the dead None-check around apply_depth_filters' return value, since it never r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
    [camera_controller.py]
2026-09-02 feat(sync-workflow): add confidence gating and stricter temporal fusion
    - Add gate_by_confidence to zero out depth pixels below a sensor confidence threshold.
    - Require a minimum number of valid temporal samples per pixel in fuse_depth_frames before it survives the median.
    - Wire --min-valid-samples and --min-confidence CLI knobs through capture_fused_rgbd, raise the frames-per-angle default to 15, and record the new settings in scan metadata.
2026-09-02 feat(sync-workflow): reconstruct with measured orbit geometry
    - Transform the fitted orbit centre and axis into the reference point-cloud camera frame.
    - Emit measured orbit geometry from valid radius calibrations.
    - Load measured pivots and axes during reconstruction and record their source.
    - Cover point and direction transforms with focused calibration tests.
2026-09-02 docs(sync-workflow): document the scan accuracy pipeline
    - Explain float depth back-projection, temporal fusion, and the enabled Orbbec filter chain.
    - Document measured orbit geometry and its reconstruction precedence.
    - Record quality baselines, LingBot exclusion measurements, and pending rig validation.
    - Call out the current confidence-gating and fill-rate reporting limitations.
2026-09-04 feat(sync-workflow): crop scans with an orbit-axis cylinder
    - Add CylinderCrop, a radial-and-axial crop region around the measured orbit axis, and apply it in both the registration and full-resolution crop paths.
    - Add --crop-shape and --crop-axial-half-length-m to reconstruct_pipeline.py and main_scan.py, keeping cube the default so existing datasets reconstruct unchanged.
    - Prefer the cylinder for this rig, since the enclosure ring sits 90-115 mm from the orbit axis while the object stays inside 55 mm but runs +/-120 mm along it, so every cube small enough to drop the ring also clips 21-39% of the object, whereas an 80 mm cylinder keeps all of the object and none of the ring.
    - Record the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
2026-09-04 feat(radius-calibration): gate the orbit fit on its own residual
    - Reject a calibration whose inlier circle-fit RMSE exceeds 2 mm or whose maximum inlier residual exceeds 5 mm, since reprojection error reports only how cleanly the marker corners were detected and cannot detect a fitted circle that misses the machine.
    - Add --max-fit-rmse-mm and --max-fit-residual-mm, and record both thresholds in the calibration acceptance block.
    - Raise the --min-markers-per-pose default to 2, since single-marker planar pose is ambiguous out of plane in exactly the directions the orbit fit needs.
    - Cover the gate with clean, failing, and threshold-override orbit fits.
    [radius_calibration.py, test_radius.py]
2026-09-04 fix(sync-workflow): reject an orbit calibration from another X station
    - Raise when the --orbit-geometry calibration's motor X station does not match the scan's, mirroring the check the ArUco pose-map path already performs.
    - Note that pose priors survive a station mismatch, since rotation about a line is invariant to sliding the pivot along it, but the crop centre does not, so the crop cube is displaced by the whole station offset and encloses rig geometry.
    - Warn instead of raising when a calibration records no motor station, and skip the check entirely when --pivot already overrides the crop centre.
    - Cover matching, mismatched, and station-less calibrations with focused tests.
    [reconstruct_pipeline.py]
2026-09-04 feat(sync-workflow): measure accuracy against a certified ball bar
    - Add sphere_bar_report.py, which clusters a merged cloud into two spheres, fits each in closed form, and reports centre-to-centre distance against the certified length plus per-sphere diameter and form error.
    - Report the scale error and the implied orbit-radius correction ratio, since a proportional error in the measured length is a proportional error in the calibrated radius.
    - Break the circularity of the existing metrics, since plane-RMS, cross-view residual and ICP fitness all measure the pipeline against itself and stay happy around a wrong radius, whereas a certified length is traceable.
    - Reject a cluster whose fitte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
    [sphere_bar_report.py]
2026-09-04 feat(sync-workflow): report repeatability between two rigid scans
    - Add --compare-merged, which compares two merged clouds of the same rigid object and records the comparison under a repeatability section.
    - Report the residual both as reconstructed and after rigid re-alignment, since the first carries the frame drift a nozzle trajectory would inherit while the second isolates how reproducible the measured shape is, and a large gap between them points at the orbit calibration rather than the sensor.
    - Record the rigid transform that alignment applied, so frame drift is reported as a magnitude rather than inferred from the residual drop.
    - Add nearest_neighbour_stats, which raises when the cl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
    [scan_quality_report.py]
2026-09-04 docs(sync-workflow): document the crop, calibration and accuracy changes
    - Describe --crop-shape and --crop-axial-half-length-m, and record why the cylinder beats every cube on this rig.
    - Document the circle-fit residual gate and the raised marker minimum, and note that the existing X=100 calibration fails both.
    - Explain that reconstruction now refuses a calibration from another X station, and why pose priors survive a mismatch while the crop centre does not.
    - Document sphere_bar_report.py and the repeatability section, and state plainly that every other metric measures the pipeline against itself and cannot detect a wrong orbit radius.
2026-09-04 fix(radius-calibration): reject ambiguous poses instead of demanding two markers
    - Return the previous --min-markers-per-pose default to 1, since the four-face profile shows a second marker only near corner-on views: only 39 of 107 accepted poses in outputs/test_radius_x100 saw two, and only 4 of 13 angles kept six of those, so requiring two fails the angular-coverage gate outright.
    - Report ippe_error_ratio from the single-marker solver, the factor by which the winning IPPE solution outfits the discarded one, since a square marker admits two poses mirrored about the image plane and choosing the lower reprojection error is a coin flip when both fit nearly as well.
    - Reject a pose whose ratio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
    [radius_calibration.py, test_radius.py]
2026-09-04 test(radius-calibration): assert the ambiguity gate, not the marker count
    - Replace the single-marker rejection test, which encoded the previous policy, with cases for an unambiguous pose being accepted and an ambiguous one being rejected.
    - Keep a case for --min-markers-per-pose 2, so demanding two faces explicitly is still covered.
2026-09-04 fix(radius-calibration): register the --min-ippe-error-ratio argument
    - Add the parser argument and lower the --min-markers-per-pose default to 1, which the previous commit described and wired through validate_args, estimate_frame_pose and the acceptance block but never registered, so every run died on a missing attribute.
    - Cover parse_args and validate_args together, since no test exercised this script's parser and nothing caught a gate that was read but never declared.
    [test_radius.py]
2026-09-04 fix(radius-calibration): gate reprojection error per marker count
    - Apply --max-reprojection-error-px, raised to 3.0, only to multi-marker poses, and gate single-marker poses with --max-single-marker-reprojection-error-px at 1.0, since four coplanar points are solved almost exactly by IPPE and the error is near zero however wrong the pose is.
    - Correct an inverted gate: in outputs/radius_x100_rerun the 145 single-marker poses had a 0.124 px median error and all passed, while the 90 two-marker poses had a 1.050 px median and every one of the 22 reprojection rejections was two-marker, so the limit discarded only the measurements it could actually judge.
    - Prefer multi-marker frames in build_fi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
    [radius_calibration.py, test_radius.py]
2026-09-04 fix(radius-calibration): gate the radius uncertainty, not the residual scatter
    - Replace the per-observation RMSE and max-residual gates with --max-radius-std-mm at 0.25 mm, since single-marker poses are noisy but unbiased and average to a stable radius: outputs/radius_x100_rerun2 pairs a 3.207 mm observation RMSE with a 0.194 mm bootstrap standard deviation, and two runs fifteen minutes apart agreed to 0.058 mm while individual angles moved by up to 8.5 mm.
    - Report per-angle median residuals in angle_median_residual_m as diagnostics, so a repeatably poor view such as +120 degrees stays visible without being acted on.
    - Do not exclude high-residual angles, having measured that it hurts: acr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
    [radius_calibration.py, test_radius.py]
2026-09-04 fix(radius-calibration): bootstrap whole angles, not individual frames
    - Add cluster_labels to bootstrap_radius_ci and pass the motor angle, so resampling draws whole bursts, since the ten frames captured at one angle share that angle's pose error and are not independent draws.
    - Correct a radius uncertainty that was optimistic by 1.9x: across three runs of the same rig the per-frame bootstrap claimed a 0.165 mm mean standard deviation while the radii spread with a 0.324 mm standard deviation, and resampling by angle reports 0.39-0.54 mm instead.
    - Require at least three clusters and reject label lists that do not match the points, rather than silently reporting a spread drawn from too few i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
    [radius_calibration.py]
2026-09-04 fix(sync-workflow): run the two depth filters the device omits
    - Construct NoiseRemovalFilter and EdgeNoiseRemovalFilter directly from the SDK when the device leaves them out of get_recommended_filters(), since naming a filter that list omits enabled nothing and reported nothing, so three of the five requested filters were running.
    - Warn when a requested filter is neither recommended by the device nor constructible, rather than dropping it silently.
    - Correct the ordering comment: the spatial and temporal filters work in the disparity domain, so DisparityTransform converts back to depth after them rather than staying first, which is the order the Gemini 305 itself reports.
    - Record that the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
    [depth_filters.py]
2026-09-04 feat(sync-workflow): drop detached clusters from the merged cloud
    - Discard any connected component smaller than 1 percent of the largest after the final SOR, since statistical outlier removal judges a point by its own neighbourhood and a compact blob of noise floating clear of the object looks healthy from the inside and survives.
    - Drop points that belong to no component alongside the undersized ones, and add --keep-all-components to disable the filter entirely.
    - Remove 2029 of 140110 points on outputs/scan_x100_r143259, 1.4 percent in 34 clusters, leaving the 138081-point body intact; the gap to the next largest cluster at 286 points is wide enough that any threshold between 0.5 and 5 pe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
    [pointcloud_processing.py, reconstruct_pipeline.py]
2026-09-08 docs(sync-workflow): chart the pipeline end to end
    - Add WORKFLOW.md with Mermaid charts for the orbit calibration, the capture loop and its depth filter chain, the four reconstruction stages, and the validation reports.
    - Show where each gate can stop a run: the split reprojection thresholds and the IPPE ambiguity ratio, the radius uncertainty check, the X station match, and the ICP guards with their fallback to the motor prior.
    - Contrast the cube and cylinder crops with the measured reason the cylinder wins on this rig, and separate the internally consistent metrics from the ball bar as the only traceable one.
    - Record which artefact each stage produces and consumes, and why a calibration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
2026-09-08 docs(sync-workflow): separate the calibration and capture stages in the chart
    - Split the top-level chart into a once-per-machine calibration with the ArUco bar in the rig and a per-scan capture with the hand in it, since drawing both feeding reconstruction read as though they happen together.
    - State that main_scan.py contains no marker code at all and that reconstruction reads the calibration file rather than needing a marker in view.
    - Note that the calibration is re-run only when the mechanics change or the X station does.
2026-09-08 refactor(sync-workflow): remove ArUco pose-map reconstruction
    - Remove the per-angle ArUco registration modes and pose-map input while retaining the marker-based orbit calibration tools.
    - Keep motor orbit priors as the reconstruction path and retain the existing station-adjustment work needed to reuse measured calibration across X stations.
    - Remove the obsolete reconstruction documentation and tests, and reject the removed CLI options explicitly.
    - Correct two baseline test fixtures to match the existing negative X-offset transform convention; leave the physical transform unchanged.
    - Verify reconstruction and calibration pose-map coverage: 35 tests and 3 subtests pass.
    [reconstruct_pipeline.py]
2026-09-08 feat(sync-workflow): default to calibrated geometry and guarded ICP
    - Use the fixed test_radius_x100 calibration for measured pivot, axis and recommended radius, with an explicit file override and scan-metadata handoff for later reconstruction.
    - Validate calibration before hardware access and require matching camera coordinate frames when recorded, rather than silently reverting to an assumed orbit centre.
    - Default capture and standalone reconstruction to guarded ICP while keeping motor-only registration and explicit radius and pivot overrides.
    - Reuse one calibration across X stations, keep high-drift exclusion and cleanup settings unchanged, and document the shared-file selection and pre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
    [main_scan.py, orbit_geometry.py, reconstruct_pipeline.py]
2026-09-08 perf(sync-workflow): shorten the per-angle capture cycle
    - Reduce the default fused burst from 15 to 6 fresh RGB-D frames while retaining the three-valid-sample requirement.
    - Raise the scan Y feedrate from 500 to 800 and reduce the post-move settling delay from 0.5 to 0.1 seconds to shorten each capture cycle.
    - Update the capture documentation and workflow chart to match the faster settings.
    - Verify the workflow suite with these settings: 177 tests and 8 subtests pass. This checks software behavior; scan accuracy at the faster settings remains a hardware measurement.
    [main_scan.py]
2026-09-08 feat(filter-testing): add isolated SDK depth filter comparisons
2026-09-08 fix(filter-testing): avoid restoring hardware settings during playback
2026-09-08 feat(filter-testing): add Matplotlib overview and 1280x800 capture default
2026-09-09 feat(filter-testing): add noise removal parameter trials
2026-09-09 feat(sync-workflow): set 1280x800 disparity 128 and explicit capture filters
    - Set the default capture resolution to 1280x800 and the disparity search range to 128 for the Gemini 305 workflow.
    - Pin and read back the selected spatial, temporal, noise-removal and edge-noise parameters instead of silently relying on SDK defaults.
    - Document the 95 mm minimum-depth limitation for this resolution/disparity combination and verify the new defaults with workflow tests.
    [camera_controller.py, depth_filters.py, main_scan.py]
2026-09-09 feat(filter-testing): add Gemini capture and LingBot depth comparison
    - Capture a stationary RGB-D pair with explicit scanner filters, float depth and RGB rectified to the aligned depth grid.
    - Run the example model offline with normalized intrinsics and save shared-scale depth previews, changes and validity masks for comparison.
    - Validate preprocessing with four tests and exercise CUDA inference on the existing Gemini sample; leave fresh 1280x800 capture validation to the rig test.
2026-09-09 feat(sync-workflow): fuse registered captures with a TSDF volume
    - Add optional volumetric fusion that averages the registered views into one signed-distance field instead of concatenating their clouds, so independent per-view error cancels rather than stacking; on a 37-view sensor scan this lowers plane-fit residual from 0.873 mm to 0.583 mm and yields a mesh alongside the cloud.
    - Recover each capture's depth by reprojecting its camera-frame PLY, which inverts the pinhole back-projection exactly and so needs no raw rgbd/ directory; prefer the ungated rgbd/ depth when a scan recorded one, and reject any cloud that misses the pixel grid rather than fusing a transformed one.
    - Mask depth ag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
    [reconstruct_pipeline.py, tsdf_fusion.py]
2026-09-10 refactor(sync-workflow): remove auto-radius reconstruction
    - Remove the rough visible-surface depth heuristic so reconstruction always uses measured calibration geometry or an explicit orbit-radius override.
    - Remove the obsolete CLI option and its diagnostics source value.
    - Update reconstruction documentation and cover rejection of the retired option.
    - Verify Python compilation and default CLI parsing; the full reconstruction suite requires Open3D, which is unavailable in this environment.
2026-09-10 feat(sync-workflow): clean TSDF hand meshes
    - Preserve the raw TSDF mesh and write a cleaned companion mesh for drawing-surface inspection.
    - Remove malformed and detached geometry, fill only holes up to 3 mm, and apply light non-shrinking Taubin smoothing to reduce scan ripple.
    - Record cleanup settings and raw-versus-cleaned mesh statistics in reconstruction diagnostics.
    - Verify focused TSDF coverage in the hena_jet Open3D 0.19 environment: 15 tests pass.
2026-09-10 feat(sync-workflow): default to smooth TSDF reconstruction
    - Make the hand-scan TSDF workflow the default: write both fusion outputs with an 80 mm cylindrical crop and 300 mm axial half-length.
    - Increase non-shrinking Taubin smoothing from three to ten iterations to suppress residual surface ripple.
    - Keep point-only fixtures explicit so legacy reconstructions without intrinsics remain covered.
    - Verify reconstruction and TSDF coverage in hena_jet: 49 tests and 3 subtests pass.
    [main_scan.py, reconstruct_pipeline.py, tsdf_fusion.py]
2026-09-10 fix(sync-workflow): adjust final crop radius for improved accuracy - adjust DEFAULT_FINAL_CROP_RADIUS_M to 0.085
    [reconstruct_pipeline.py]
2026-09-10 fix(sync-workflow): align hand crop defaults
    Use the measured 85 mm crop for new captures and direct reconstruction documentation.
    Keep guarded ICP constrained to the final crop and cover the recorded metadata defaults.
    [main_scan.py, reconstruct_pipeline.py]
2026-09-11 refactor(sync-workflow): remove the unsupported confidence-gate flag
    - Remove --min-confidence and gate_by_confidence(): the Gemini 305's datasheet lists only Depth, Color, and IR streams, and the Orbbec SDK's per-device profiles ship no confidence stream for this camera, so the gate could never be wired into capture.
2026-09-11 refactor(sync-workflow): remove the orphaned pose-map capture tools
    - Delete capture_orbit_pose_map.py and orbit_pose_map.py: their only consumer, reconstruct_pipeline.py's --pose-map reconstruction mode, was removed in 8a444b2, leaving these capture and helper modules with no caller.
    - Drop their row from calculating_radius/README.md and correct the package docstring, which still advertised measured-pose calibration helpers.
